HexabitzPlatform/H0FR8x-Hardware/README.md

# H0FR8x-Hardware
Hexabitz AC Dimmer Module Hardware Design
