HexabitzPlatform/H0FR8x-Hardware/Released/BOM/H0FR8.xlsx

 |  | www.hexabitz.com info@hexabitz.com |  | Bill Of Materials
Customer | Hexabitz | Revision | 0
Project | Hexabitz Modules | Date | 26/11/2024
Board | AC Dimmer (H0FR8) | Notes
Designator | Description | Manufacturer Part Number | Manufacturer | Octopart Url | Quantity
RESET | Headers & Wire Housings Unshrouded 1 POS T/H | 5-146280-1 | TE Connectivity | https://octopart.com/5-146280-1-te+connectivity+%2F+amp-40259676?r=sp | 1
SWD | Conn Unshrouded Header HDR 3 POS 2.54mm Solder ST Top Entry Thru-Hole Carton | 5-146281-3 | TE Connectivity | https://octopart.com/5-146281-3-te+connectivity+%2F+amp-39745942?r=sp | 1
AC_MAINS, LOAD | Modular Terminal Block, 15A, 1 Row(s), 1 Deck(s) | 1546111-2 | TE Connectivity | https://octopart.com/1546111-2-te+connectivity+%2F+amp-40393356 | 2
H_S | Heat Sink TO-263 (D²Pak) Copper Top Mount | ATS-PCB1073 | Advanced Thermal Solutions Inc. | https://octopart.com/ats-pcb1073-advanced+thermal+solutions-51854777 | 1
R3 | RES SMD 0.0OHM JUMPER 1/10W 0603 | RC0603JR-070RL | YAGEO [VR] | https://octopart.com/rc0603jr-070rl-yageo-1241539?r=sp | 1
R9, R14 | RES 47 OHM 1% 1/10W 0603 | RC0603FR-0747RL | Yageo | https://octopart.com/rc0603fr-0747rl-yageo-40952917 | 2
R5 | RES 100 OHM 1% 1/10W 0603 | AC0603FR-13100RL | Yageo | https://octopart.com/ac0603fr-13100rl-yageo-74169481?r=sp | 1
R12 | RES SMD 100 OHM 5% 1/2W 0805 | ERJ-P06J101V | Panasonic | https://octopart.com/erj-p06j101v-panasonic-39989292 | 1
R1 | 270.0R Thick Film Resistors - SMD 0603 | RC0603FR-07270RL | Yageo | https://octopart.com/rc0603fr-07270rl-yageo-9288890?r=sp | 1
R6 | RES SMD 390 OHM 5% 1/2W 0805 | ERJ-P06J391V | Panasonic | https://octopart.com/erj-p06j391v-panasonic-39814046 | 1
R4 | RES 1K OHM 1% 1/10W 0603 | AC0603FR-131KL | Yageo | https://octopart.com/ac0603fr-131kl-yageo-73876229 | 1
R13 | RES SMD 1.5K OHM 5% 1/2W 0805 | ERJ-P06J152V | Panasonic | https://octopart.com/erj-p06j152v-panasonic-39824464 | 1
R8 | RES 3.3K OHM 1% 1/10W 0603 | RC0603FR-073K3L | Yageo | https://octopart.com/rc0603fr-073k3l-yageo-40011875 | 1
R2 | RES 10K Ohm 1% 0603 | RC0603FR-0710KL | Yageo | https://octopart.com/rc0603fr-0710kl-yageo-40025538?r=sp (https://octopart.com/crcw060310k0jneb-vishay+dale-46603268) | 1
R7 | RES SMD RMC 33k OHM 0603 1/10W 5% | 0603WAJ0333T5E | Royal Ohm | https://octopart.com/0603waj0333t5e-royal+ohm-127861239 | 1
R15 | RES 100K OHM 1% 1/10W 0603 | RC0603FR-07100KL | Yageo | https://octopart.com/rc0603fr-07100kl-yageo-40946036?r=sp | 1
R10, R11 | RES SMD 100K OHM 5% 1/2W 0805 | ERJ-P06J104V | Panasonic | https://octopart.com/erj-p06j104v-panasonic-39853801 | 2
C5, C13 | CAP CER 1000PF 10V X7R 0603 | C0603C102K8RACTU | KEMET | https://octopart.com/c0603c102k8ractu-kemet-9143718 | 2
C9 | CAP CER 10000PF 50V X7R 0603 | C0603C103K5RACTU | KEMET | https://octopart.com/c0603c103k5ractu-kemet-133094 | 1
C10 | CAP CER 10000PF 450V X7T 0805 | C2012X7T2W103M085AA | TDK | https://octopart.com/c2012x7t2w103m085aa-tdk-28169246 | 1
C11 | CAP CER 0.047UF 450V X7T 0805 | C2012X7T2W473K125AA | TDK | https://octopart.com/c2012x7t2w473k125aa-tdk-26013889 | 1
C1,C7,C8, C12 | CAP CER 0.1 UF 25V 10% X7R 0603 | CL10B104KA8NNNC | Samsung Electro-Mechanics | https://octopart.com/cl10b104ka8nnnc-samsung-19831573?r=sp (https://octopart.com/c0603c104k8ractu-kemet-145075?r=sp&s=9bS9ASSwSEqMCE9KBEQZ0g) | 4
C2 | CAP CER 1 UF 16V X7R 0805 | CC0805KKX7R7BB105 | YAGEO [VA] | https://octopart.com/cc0805kkx7r7bb105-yageo-8376555?r=sp | 1
C3 | CAP CER 4.7UF 16V X7R 0805 | C0805C475K4RACTU | KEMET [VA] | https://octopart.com/c0805c475k4ractu-kemet-22859922?r=sp (https://octopart.com/grm21bc81e475ka12l-murata-10331911?r=sp&s=RY3qZSD8T6mG6TC9CHI5qQ) | 1
VDR1 | LA Series 369 VDC 275 V RMS 710 V Clamp 1200 A 80 pF Radial Lead Varistor | V275LA4P | Littelfuse | https://octopart.com/v275la4p-littelfuse-572229 | 1
FB1 | FERRITE BEAD 30 OHM 0603 1LN | MMZ1608Y300BTA00 | TDK | https://octopart.com/mmz1608y300bta00-tdk-7906990?r=sp | 1
D1 | LED Uni-Color Super Red 639nm 2-Pin Chip 0603(1608Metric) T/R | VLMS1300-GS08 | Vishay | https://octopart.com/vlms1300-gs08-vishay-21709201?r=sp | 1
D2 | TVS DIODE 3.3VWM 10.9VC SOD323 | CDSOD323-T03SC | Bourns | https://octopart.com/cdsod323-t03sc-bourns-10487153 | 1
Z1, Z2 | Zener Diode 3 V 500 mW ±5% Surface Mount SOD-123 | MMSZ5225BT1G | onsemi | https://octopart.com/mmsz5225bt1g-onsemi-56609 | 2
Q1 | Transistor, Bipolar, Si, NPN, General Purpose, VCEO 40VDC, IC 200mA, PD 225mW, SOT-23 | MMBT3904LT1G | ON Semiconductor | https://octopart.com/mmbt3904lt1g-on+semiconductor-3280?r=sp | 1
Q2 | Thyristor TRIAC 600V 210A 3-Pin(2+Tab) D2PAK Tube | T2035H-6G | STMicroelectronics | https://octopart.com/t2035h-6g-stmicroelectronics-9417760 | 1
U1 | MCU 32-bit ARM Cortex M0+ RISC 512KB Flash 1.8V/2.5V/3.3V 48-Pin UFQFPN EP Tray | STM32G0B1CEU6 | STMicroelectronics | https://octopart.com/stm32g0b1ceu6-stmicroelectronics-116363364?r=sp | 1
U3 | Optocoupler, Triac, 3.75Kv, Sop-4 Rohs Compliant: Yes |Vishay VOT8121AM-VT | VOT8121AM-VT | Vishay | https://octopart.com/vot8121am-vt-vishay-96774453 | 1
U4 | AC Input-Transistor Output Optocoupler, 1-Element, 3750V Isolation | TLP184(GR-TPL,SE | Toshiba | https://octopart.com/tlp184%28gr-tpl%2Cse%28t-toshiba-33798875 | 1
X1 | 8,0000MHZ 33pF SMD MURATA Resonators | CSTNE8M00G550000R0 | Murata | https://octopart.com/cstne8m00g550000r0-murata-91406934?r=sp | 1
