HexabitzPlatform/H0FR8x-Hardware/Documentation/H0FR8 Schematics.pdf

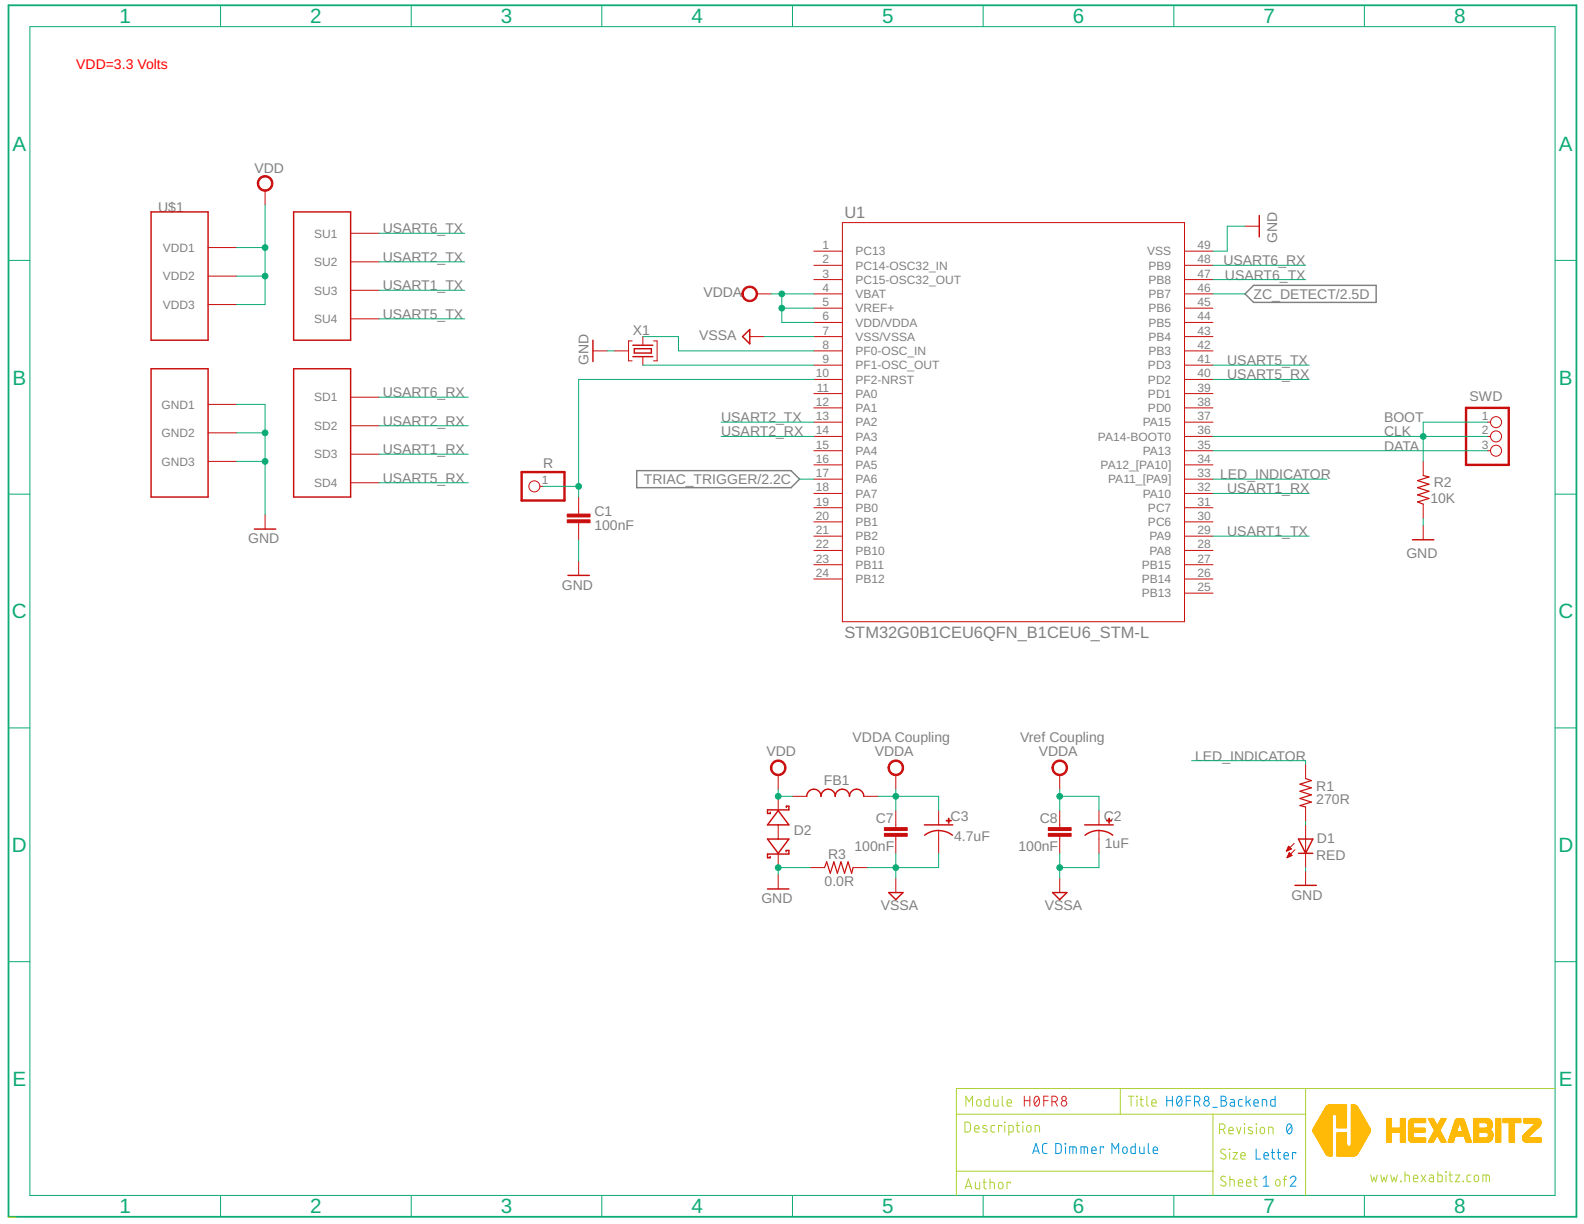
[picture p1: page 1]

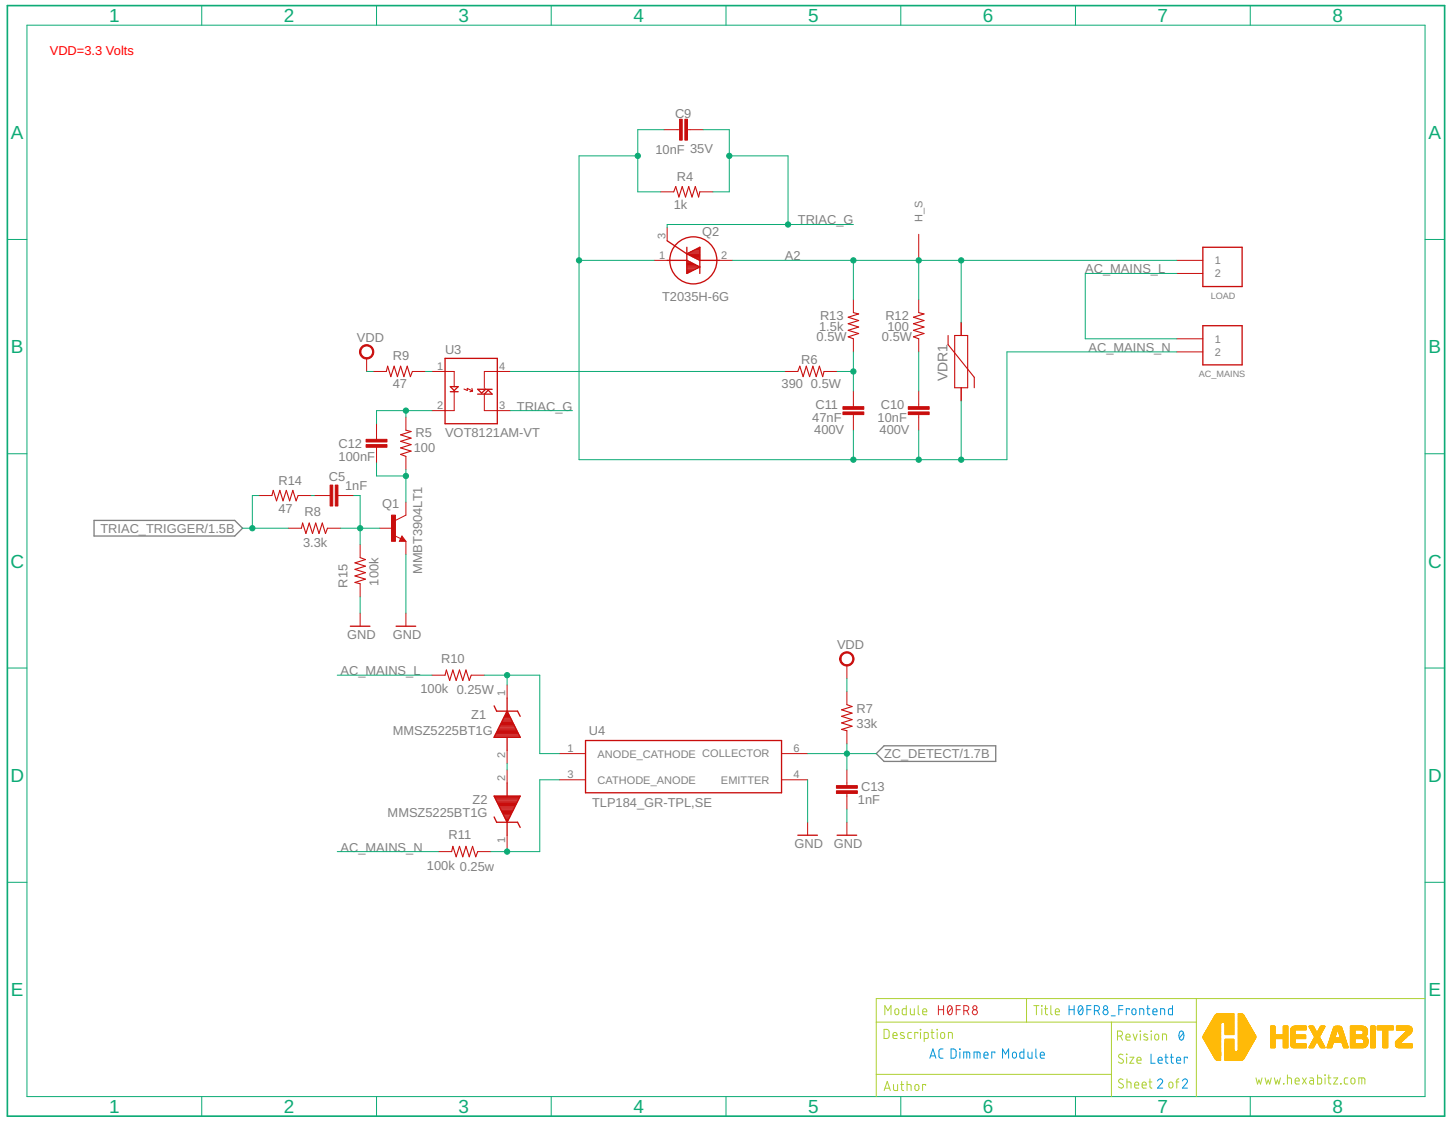
[picture p2: page 2]
