HexabitzPlatform/H0FR8x-Hardware/Design/H0FR8.brd

## EAGLE design Design/H0FR8.brd (2024-12-18)

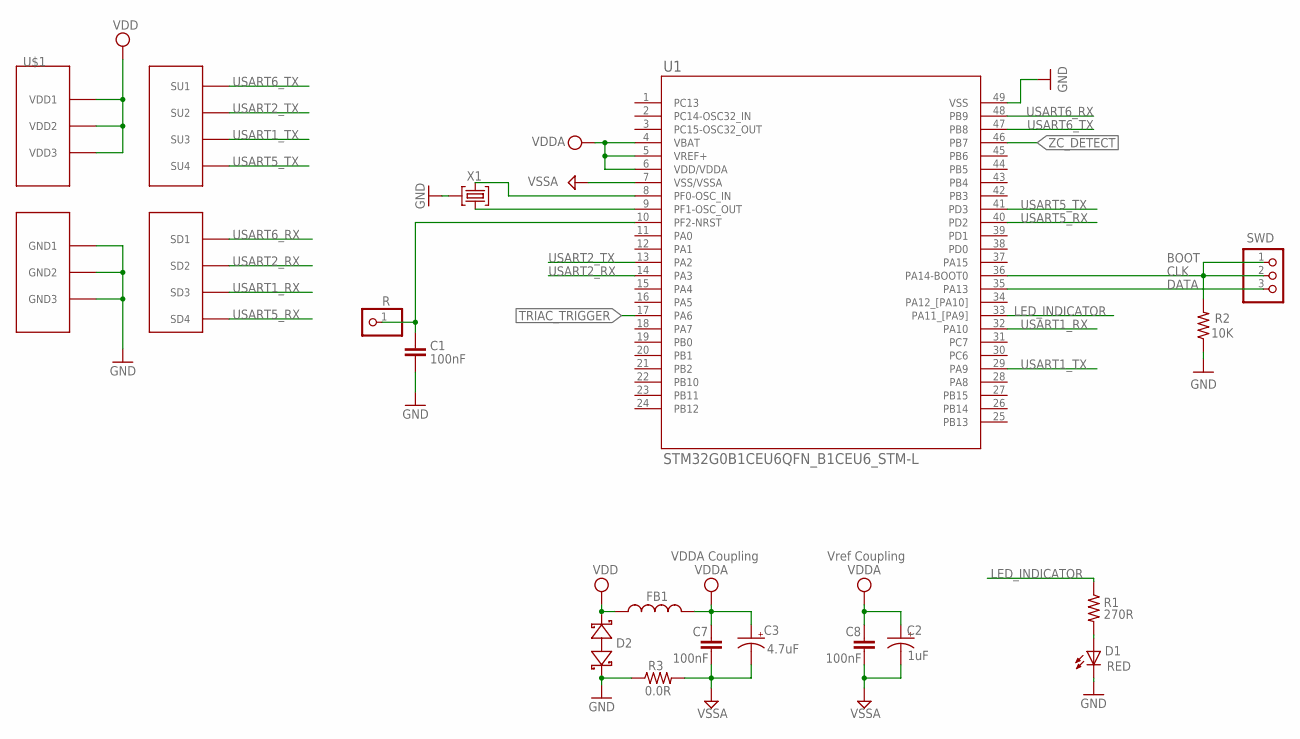
[picture p3: schematic H0FR8.sch, sheet 1]

Parts:
C1, C7, C8: 100nF; C-0603
C2: 1uF; C-0805-POL; TOLERANCE 10%; VOLTAGE_RATING 16V; MPN CC0805KKX7R7BB105
C3: 4.7uF; C-0805-POL; TOLERANCE 10%; VOLTAGE_RATING 25V; MPN GRM21BC81E475KA12L
D1: RED; VLMS1300-GS08; MPN VLMS1300-GS08
D2: BOURNS_CDSOD323-T03SCBOURNS_CDSOD323-T03SC_0_0; BOURNS_CDSOD323-T03SC_0
FB1: FB-0603
R: R; 1X01
R1: 270R; R-0603
R2: 10K; R-0603
R3: 0.0R; R-0603
SWD: PINHD-1X3; 1X03
TRIMBLE-LOGO2: HEXA-LOGO
U1: STM32G0B1CEU6QFN_B1CEU6_STM-L; QFN_B1CEU6_STM-L
U$1: HEXABIT_17.32_X3_NO_P1_P2_P3_P4_P5_P6_P11_P12
X1: XTALL_CSTCE8M00G52

Connections:
CLK: R2.2, SWD.1, SWD.2, U1.36 (PA14-BOOT0)
DATA: SWD.3, U1.35 (PA13)
GND: C1.2, D1.C, D2.2 (C), R2.1, R3.1, U1.49 (VSS), U$1.PAD_PD12 (GND1), U$1.PAD_PD17 (GND2), U$1.PAD_PD19 (GND3), X1.P$2 (2); also elsewhere on the board
LED_INDICATOR: R1.1, U1.33 (PA11_[PA9])
unnamed: D1.A, R1.2
unnamed: C1.1, R.1, U1.10 (PF2-NRST)
unnamed: U1.9 (PF1-OSC_OUT), X1.P$1 (1)
unnamed: U1.8 (PF0-OSC_IN), X1.P$3 (3)
TRIAC_TRIGGER: U1.17 (PA6); also elsewhere on the board
USART1_RX: U1.32 (PA10), U$1.PAD_PD2 (SD3)
USART1_TX: U1.29 (PA9), U$1.PAD_PU2 (SU3)
USART2_RX: U1.14 (PA3), U$1.PAD_PD1 (SD2)
USART2_TX: U1.13 (PA2), U$1.PAD_PU1 (SU2)
USART5_RX: U1.40 (PD2), U$1.PAD_PD8 (SD4)
USART5_TX: U1.41 (PD3), U$1.PAD_PU8 (SU4)
USART6_RX: U1.48 (PB9), U$1.PAD_PD3 (SD1)
USART6_TX: U1.47 (PB8), U$1.PAD_PU3 (SU1)
VDD: D2.1 (A), FB1.1, U$1.PAD_PU12 (VDD1), U$1.PAD_PU17 (VDD2), U$1.PAD_PU19 (VDD3); also elsewhere on the board
VDDA: C2.1 (+), C3.1 (+), C7.1, C8.1, FB1.2, U1.4 (VBAT), U1.5 (VREF+), U1.6 (VDD/VDDA)
VSSA: C2.2 (-), C3.2 (-), C7.2, C8.2, R3.2, U1.7 (VSS/VSSA)
ZC_DETECT: U1.46 (PB7); also elsewhere on the board

Notes on the sheet:
Vref Coupling
VDDA Coupling
BOOT

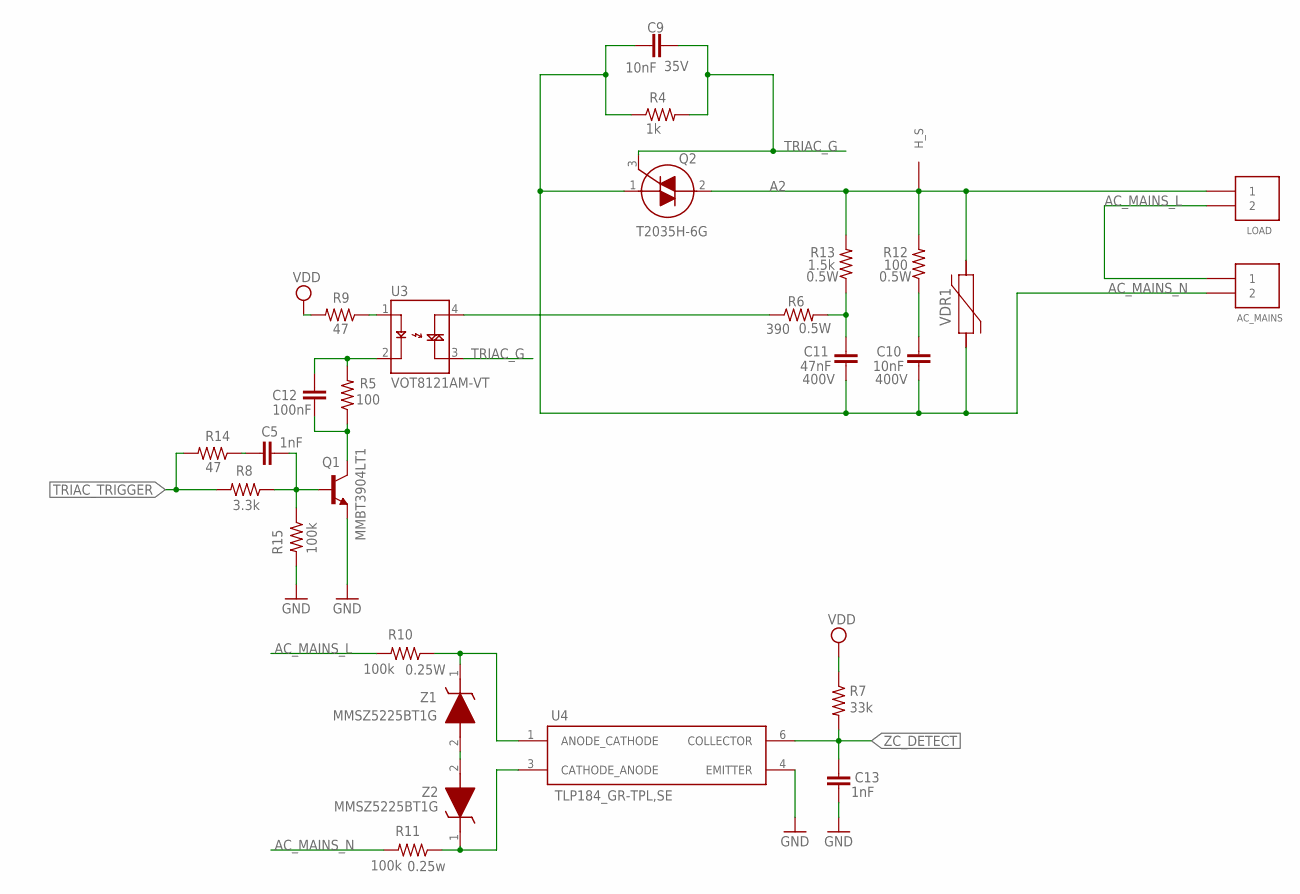
[picture p4: schematic H0FR8.sch, sheet 2]

Parts:
AC_MAINS: 1546111-2
C5, C13: 1nF; C-0603
C9: 10nF; C-0603; VOLTAGE_RATING 35V
C10: 10nF; C-0805; VOLTAGE_RATING 400V; MPN C2012X7T2W103M085AA
C11: 47nF; C-0805; VOLTAGE_RATING 400V; MPN C2012X7T2W473K125AA
C12: 100nF; C-0603
LOAD: 1546111-2
Q1: MMBT3904LT1; VOLTAGE_RATING_DC 40.0 V; MPN MMBT3904LT1G
Q2: T2035H-6G; T2035H6G
R4: 1k; R-0603
R5: 100; R-0603; TOLERANCE ±1%; MPN RC0402FR-07100RL
R6: 390; R-0805; MPN ERJ-P06J391V
R7: 33k; R-0603; TOLERANCE ±1%; MPN RC0402FR-07100RL
R8: 3.3k; R-0603; TOLERANCE ±5%; MPN RC0603JR-070RL
R9, R14: 47; R-0603; TOLERANCE ±1%; MPN RC0402FR-07100RL
R10: 100k; R-0805; TOLERANCE ±5%; MPN RC0603JR-070RL
R11: 100k; R-0805; MPN ERJ-P06J104V
R12: 100; R-0805; MPN ERJ-P06J101V
R13: 1.5k; R-0805; MPN ERJ-P06J152V
R15: 100k; R-0603; TOLERANCE ±5%; MPN RC0603JR-070RL
U3: VOT8121AM-VT; SOIC254P675X240-4N
U4: TLP184_GR-TPL,SE; SOIC254P700X230-4N
U$2: FK244D2PAK
VDR1: V275LA4P; LA_07MM_LOW_LTF
Z1, Z2: MMSZ5225BT1G; SOD3716X135N

Connections:
A2: LOAD.1, Q2.2 (MT2), R12.2, R13.2, U$2.P$1, U$2.P$2, VDR1.2
AC_MAINS_L: AC_MAINS.1, LOAD.2, R10.2
AC_MAINS_N: AC_MAINS.2, C9.2, C10.2, C11.2, Q2.1 (MT1), R4.1, R11.2, VDR1.1
GND: C13.2, Q1.2 (E), R15.2, U4.4 (EMITTER); also elsewhere on the board
unnamed: R9.1, U3.1 (A)
unnamed: C10.1, R12.1
unnamed: C11.1, R6.2, R13.1
unnamed: R6.1, U3.4 (MT2)
unnamed: C5.2, R14.1
unnamed: C12.1, R5.2, U3.2 (C)
unnamed: C12.2, Q1.3 (C), R5.1
unnamed: Z1.2 (A), Z2.2 (A)
unnamed: C5.1, Q1.1 (B), R8.1, R15.1
unnamed: R10.1, U4.1 (ANODE_CATHODE), Z1.1 (K)
unnamed: R11.1, U4.3 (CATHODE_ANODE), Z2.1 (K)
TRIAC_G: C9.1, Q2.3 (G), R4.2, U3.3 (MT1)
TRIAC_TRIGGER: R8.2, R14.2; also elsewhere on the board
VDD: R7.1, R9.2; also elsewhere on the board
ZC_DETECT: C13.1, R7.2, U4.6 (COLLECTOR); also elsewhere on the board

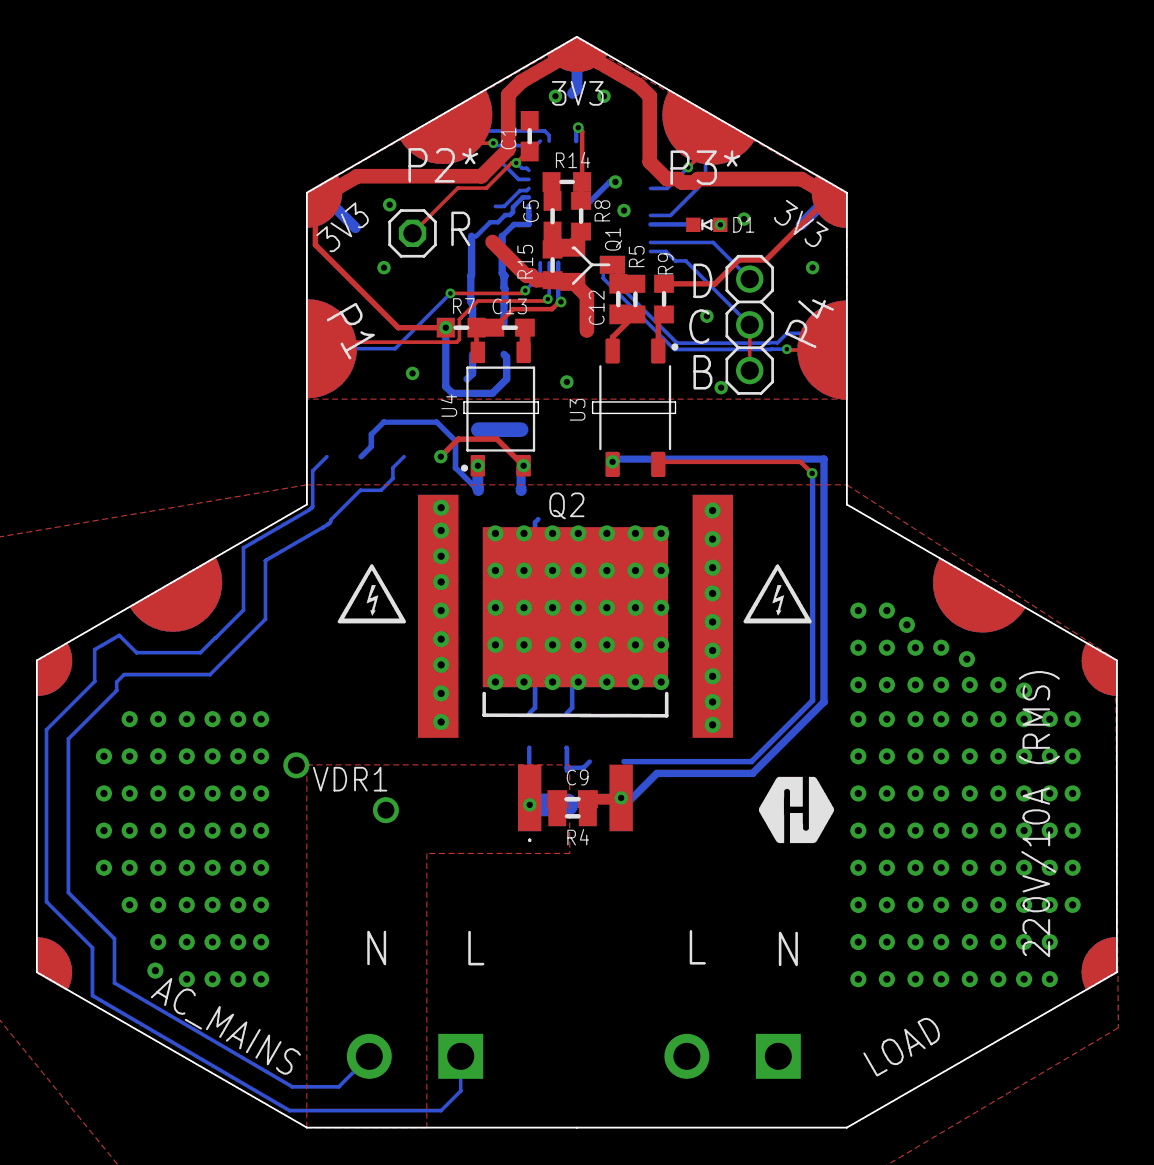
[picture p5: board H0FR8.brd from above]

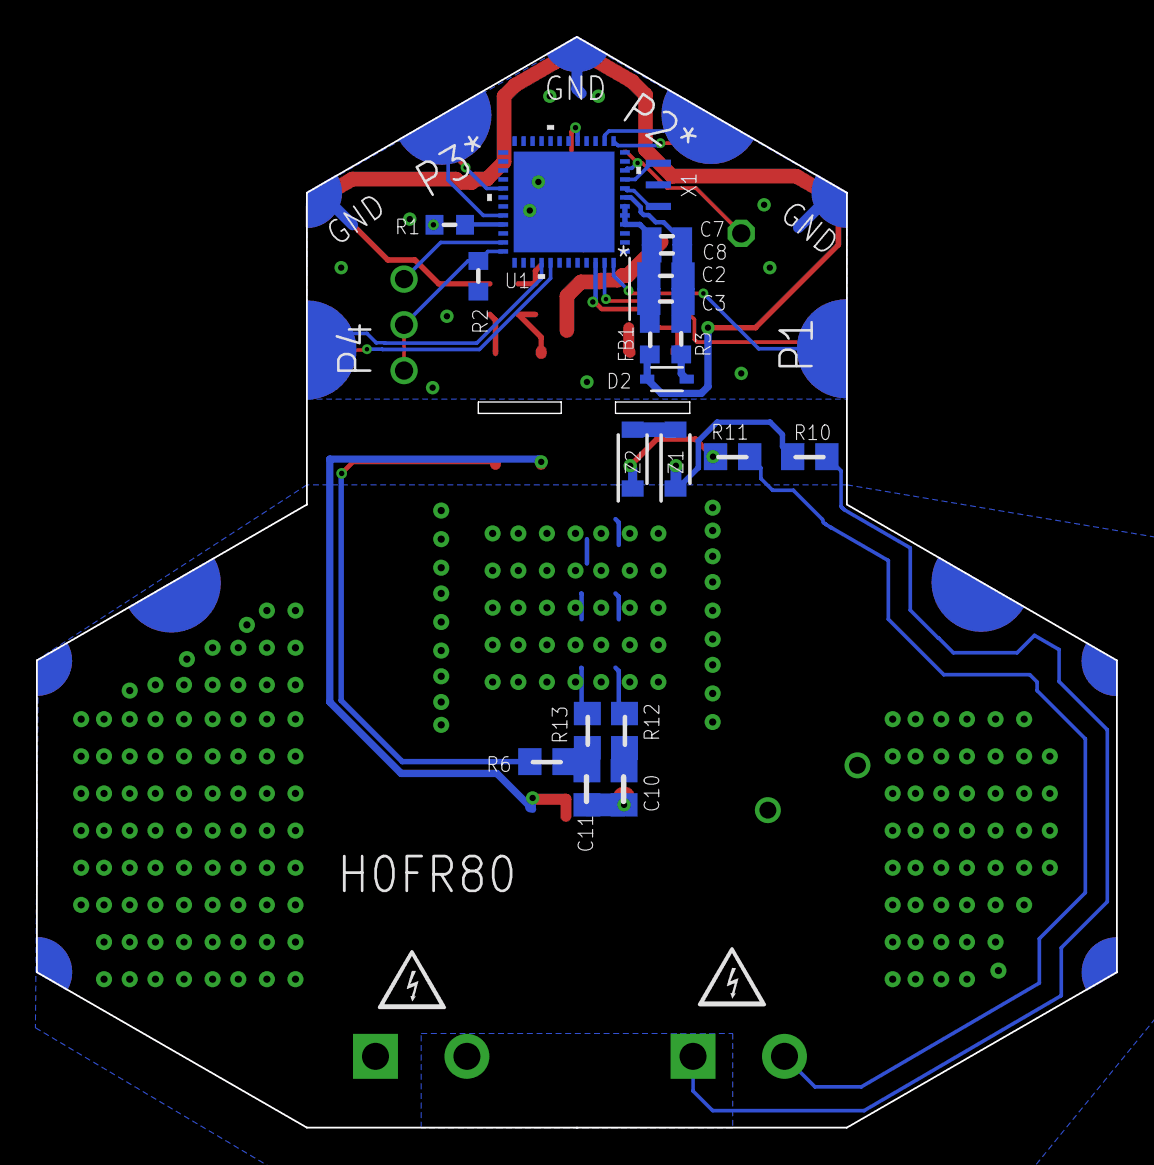
[picture p6: board H0FR8.brd from below]

Board: 2 copper layers, 60.0 x 60.6 mm, 45 parts (20 on the bottom side), 36 nets.
