HexabitzPlatform/H0FR8x-Hardware/(commit log)

2024-05-05 Create the template
    [H0FR8.brd, H0FR8.sch]
2024-05-08 Final schematic design
    [H0FR8.brd, H0FR8.sch]
2024-05-09 Schematic modification
    [H0FR8.brd, H0FR8.sch]
2024-06-01 Edit the description
    [H0FR8.brd, H0FR8.sch]
2024-11-09 Intial Layout Design
    [H0FR8.brd, H0FR8.sch]
2024-11-13 - Fixed component's footprints and 3d packages.
    [H0FR8.brd, H0FR8.sch]
2024-11-13 - Intial PCB design.
    [H0FR8.brd]
2024-11-16 - Silkscreen layer is done.
    [H0FR8.brd]
2024-11-21 - Changed connector. - Fixed nets. - new pcb layout.
    [H0FR8.brd, H0FR8.sch]
2024-11-26 - Silkscreen is done. - Alligned vias.
    [H0FR8.brd]
2024-11-26 - Generated BOM and Documentation.
    [H0FR8.xlsx]
2024-11-29 - Changed components description in BOM - Fixed issues in Layout - Fixed issues in Schematic - Generated new documentation
    [H0FR8.brd, H0FR8.sch, H0FR8.xlsx]
2024-12-14 - Rearranged components in BOM
    [H0FR8.xlsx]
2024-12-14 - Changed layout - Rearranged components in BOM
    [H0FR8.brd, H0FR8.xlsx]
2024-12-18 -The final design, all done.
    [H0FR8.brd, H0FR8.sch, H0FR8.xlsx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]
