HexabitzPlatform/H0FR8x-Hardware/(notices)

Notices in the files:
parts and their libraries:
HEXABITZ_RCLS: COPYRIGHT: Copyright (C) 2024 Ultra Librarian. All rights reserved.
HEXABITZ_ICs: COPYRIGHT: Copyright (C) 2021 Ultra Librarian. All rights reserved.
